Dan-BV/citroen-cold-air-intake/README.md

# Citroën Cold Air Intake Flange

A 3D-printable cold air intake duct for a Citroën engine bay. It takes air from the
radiator cross-member (a rectangular opening cut into the raised plastic bump in front of
the hood-seal lip) and delivers it through a bayonet socket to the OEM corrugated hose
(bellows) that plugs into the air-filter box.

The shape was designed in Autodesk Fusion against a photogrammetry scan of the engine bay,
scaled from the known Ø63 mm filter inlet, and checked for collisions with the scan.

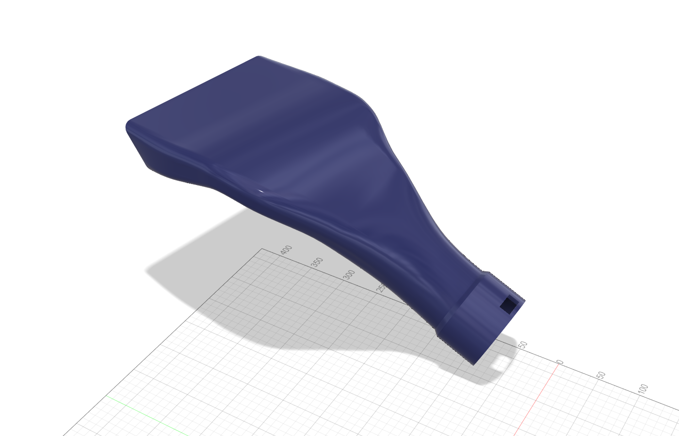
[picture p1: images/final_iso.png]
Final part


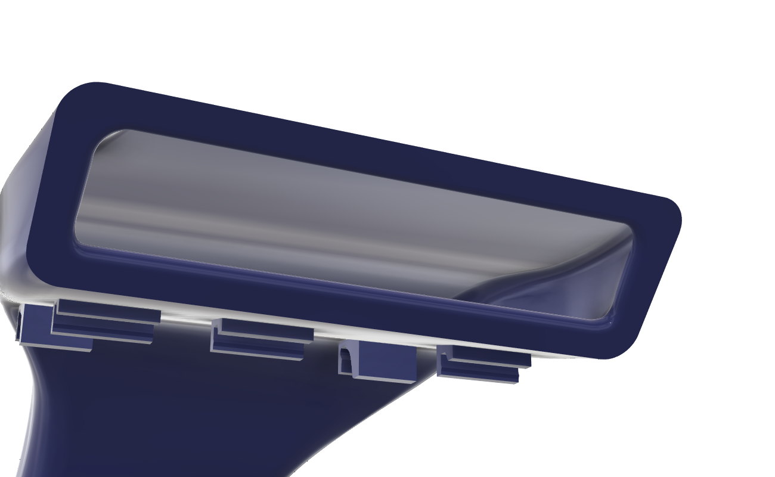
[picture p2: images/mouth_iso.png]
Mouth


## Repository layout

| Path | Contents |
|---|---|
| `model/` | Final assembled part (`.f3d`, `.step`, `.stl`) in car coordinates |
| `parts/` | The three print parts, already oriented for printing (`.stl`, `.step`, `.f3d`) |
| `print/` | Fusion print layout with all three parts on the bed |
| `references/flange_scan/` | 3D scan (OBJ) of the OEM bayonet flange used as the pattern for the outlet socket |
| `references/bellows_scan/` | 3D scan (OBJ) of the OEM corrugated hose (bellows) |
| `images/` | Renders |

All STL files are in millimetres. The full-resolution Part 1 and Part 2 STLs (≈ 105 / 55 MB,
0.01 mm chord tolerance) are too large for the repository, so they are stored zipped as
`parts/Part1_mouth_clips.stl.zip` and `parts/Part2_bend_tube.stl.zip`.

## Design summary

| Feature | Value |
|---|---|
| Inlet (mouth) | 160 × 45 mm (R9 corners) on the flat part of the rear wall of the cross-member bump, centred on it; window 140 × 25 mm (≈ 35 cm²) |
| Mounting face | Planar land offset 1 mm from the bump wall (measured profile) for 1 mm double-sided tape; land 10 mm wide all round on the flat wall |
| Inlet edge | Sharp edge; the inner walls run as straight ramps from the window to the duct over the seal lip |
| Wall thickness | 2.5 mm (wedge up to 10 mm at the mouth land) |
| Shape | Straight entry over the floor rib and the hood-seal lip (floor 16.9 mm above the floor of the apron, about 1.8 mm above the lip top), then one smooth bend down in which the section blends into a Ø63 tube, a straight Ø63 section (collar joint) and a short R55 bend onto the bellows-flange axis. Plan view: smooth trumpet 160 → ≈ 131 mm over the lip → Ø63. Narrowest section of the whole intake is the Ø54 ring of the bayonet flange (22.9 cm²); the duct over the lip is ≈ 23.5 cm² |
| Outlet | Separate bayonet flange (Part 3) on the Ø63 spigot, fitted to the measured bellows cuff with every diameter 1 mm larger than the cuff: OD 73 mm, height 46 mm; spigot sleeve Ø63.3 × 10 mm → 45° cone → Ø54 ring (flush with the cuff bore) → cuff stop → Ø62 → R4 shoulder → Ø64 up to the rim; two through windows 29° × 10 mm, two entry grooves (to Ø68) from the rim down to the windows, 30° twist; twist-lock counter-clockwise viewed into the filter inlet |
| Spigot / flange joint | The Part 2 bore narrows from Ø58 to Ø54 inside the spigot along an S-curve of two tangent R38.8 arcs (no kinks); the spigot tip is a 45° cone that seats on the flange cone, so the flow path is a continuous Ø54 from Part 2 through the flange ring into the bellows cuff, with no step or gap |
| Bellows fit | OEM bellows cuff (measured): end Ø59 with R1 edge, sealing bead Ø61, Ø60, R4 shoulder, Ø63, wall 2.5 mm (bore Ø54); two wedge lugs 15 mm wide × 9 mm long, rising to 2.5 mm (Ø67) at the back, 26 mm from the cuff end. Clearance 0.5 mm per side radially and around the lugs, 0.5 mm axial lug play. Free length ≈ 146 mm, fully compressed ≈ 109 mm; the rim position in the car is unchanged, the cuff stop is 1 mm closer to the filter than in the previous flange |
| Bellows position | Flange rim 81 mm from the filter-inlet rim (bellows close to its free length), bellows bend 25° |
| Collar joint | On the straight Ø63 section: the Part 2 collar (ID 63.3, OD 67.3, 10 mm) slides over the Part 1 tube end, butt joint with a flush Ø58 bore, 25° cone from the collar to the tube |
| Clip | Separate clip (`parts/Clip_v25`, 26 mm wide) at the mouth centre. It hooks under the rear overhang of the hood-seal lip, its top rests on the lip and its front stop runs down the lip face. It is bonded with epoxy to a tongue under the Part 1 floor through a glue tray on the clip. The tray gives ±3° / ±1 mm of play, because the lip is not parallel to the bump wall |

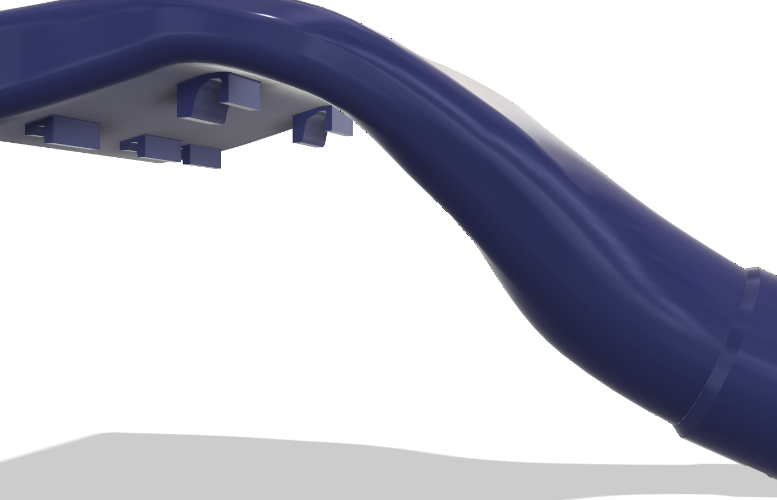
[picture p3: images/final_side.png]
Side view


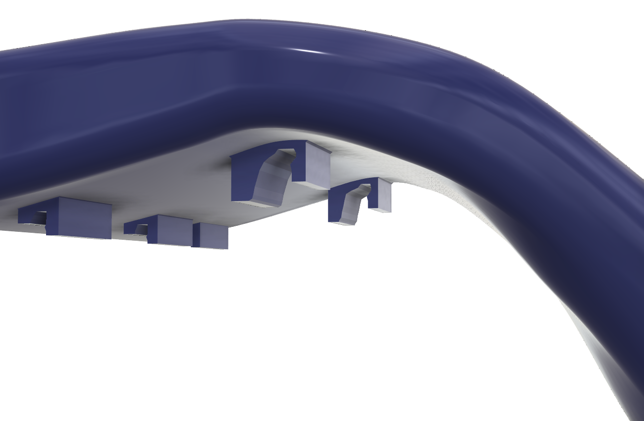
[picture p4: images/clips_side.png]
Clips


## Printing

Tested setup: Creality Ender 3 Pro (220 × 220 × 250 mm), **PETG** 1.75 mm.
PLA/PLA+ is not suitable under the hood (softens at 55–60 °C). PETG is fine at the
cross-member, especially with an external heat-reflective wrap. ASA/ABS or PA-CF are better
if you have an enclosed printer.

| Part | Size (mm) | Orientation (as exported) | Supports |
|---|---|---|---|
| `Part1_mouth_clips` | 161 × 94 × 241 | Standing on the long lower edge of the mouth, tube up (B2) | No slicer supports. Print `print/Part1_v25_B2_with_prop.stl.zip`, which includes a breakaway rib prop with a ≥ 0.32 mm gap. The prop keeps the tall part from tipping and is never inside the duct or the mouth window |
| `Clip_v25` | 21 × 6.5 × 26 | End face on the bed | None |
| `Part2_bend_tube` | 67 × 84 × 92 | Spigot tip down, collar up (use the brim of the B2 profile) | None: no overhang inside the bore is steeper than 50° (the bend leans at most 39°); outside only the 45° spigot tip chamfer and ≈ 3 cm² under the collar cone |
| `Part3_bayonet_flange` | 73 × 73 × 46 | Base (spigot sleeve) down | None (45° cone under the stop ring, windows bridge ≈ 18 mm) |

The Cura profile used for the parts is `print/cura/Ender3Pro_PETG_CAI.curaprofile` (import it via
Preferences → Profiles → Import). For Part 1 with the prop use `print/cura/Ender3Pro_PETG_CAI_v25_B2.curaprofile`:
the same settings plus a 10 mm brim, a z-hop over printed parts, and supports off. Its +0.9 mm Z offset (`adhesion_z_offset`) needs the Z Offset
Setting plugin from the Cura Marketplace; adjust it to your own printer.

Suggested PETG settings: nozzle 240–245 °C, bed 80 °C (glue stick as release layer),
fan 30–40 %, 40–50 mm/s, 4 perimeters, 30 % gyroid. Add a modifier over the clip area with
100 % infill and 5–6 perimeters. Brim 5–8 mm for parts 1 and 2. Dry the filament if it is not
fresh. Total material ≈ 400 g.

Part 1 in the B2 orientation has no overhang that needs support. The only downward face is the
underside of the tongue, ≈ 0.9 cm², which is only ≈ 1.2 mm above the duct wall below it. Use glue
stick and avoid drafts: the part is tall. After printing, snap off the prop and trim the brim flush
on the tape land. Parts 2 and 3 print with slicer supports restricted to "touching build plate"
(Z gap 0.2 mm), if any are needed.

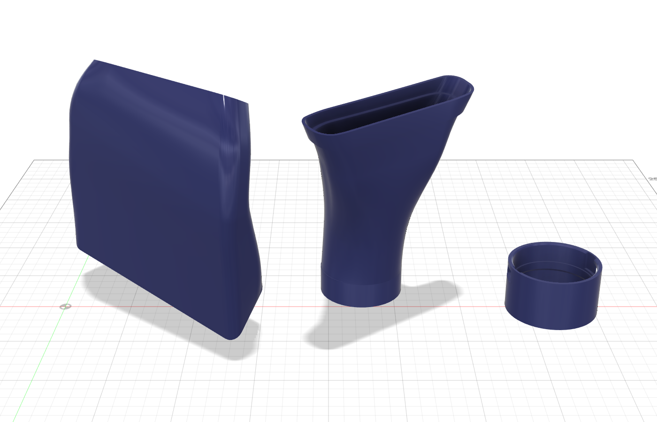
[picture p5: images/print_layout.png]
Print layout


### Fit test (optional)

The v25 test piece confirmed the fit on the car; `parts/` now holds the v25 Part 1 and clip.

v25 fixes the skew seen with the v24 test piece. The seal lip is not parallel to the bump wall:
near the clip its front face runs about 2° toward the bump and its top rises about 1°. A rigid
clip that is part of Part 1 therefore twists the whole part on the lip. In v25 the clip is a
separate piece that is bonded to Part 1 in place:
- **Clip** (`print/CAI_v25_clip.stl`, 21 × 6.5 × 26 mm): the v24 interface with the lip, plus a glue
  tray that opens upward, with end walls so that thin epoxy cannot run out. The interface: the top
  rests on the lip, the tooth sits 0.65 mm under the rear overhang, and the front stop runs down the
  lip face.
- **Part 1:** no saddle. A 19.8 × 5.3 mm tongue under the floor drops into the tray. It has about
  1 mm clearance to the tray bottom and 1–1.5 mm to the walls, so the clip can sit up to ±3° and
  about ±1 mm off the nominal position.
- **Unchanged from v24:** the land is 1.0 mm from the bump wall all round, the mouth frame has the full
  10 mm land, and the floor over the lip is at 16.9 mm.

Files:
- `print/CAI_v25_fit_test_with_clip.stl`: the test piece and the clip in one print. The test piece
  has a 5 mm deep mouth frame with the full tape land, a narrow spine from the frame to the tongue,
  and a slope where the spine meets the frame. The clip stands on its end face directly under the
  tongue, with a 0.8 mm rib support from the clip up to the tongue (≥ 0.4 mm gap) and a small bridge
  over the lip notch.
- `print/CAI_v25_fit_test_light.stl`: the test piece alone.

Print with `print/cura/Ender3Pro_PETG_TEST_fit_v25_fast.curaprofile`:
- 0.30 mm layers, 2 walls of 0.45 mm, 0 % infill;
- 80 mm/s;
- supports **off** (the rib support is part of the model);
- 7 mm brim against corner lift;
- the estimate is about 1 h 15 min to 1 h 25 min.

Glue stick on the bed and no draft help keep the frame corners down. Trim the brim flush, so that
no ridge is left on the tape land.

Install it on the car:
1. Fit the clip on the lip: hook the tooth under the rear overhang and press it down.
2. Fill the tray about half full with thick two-part epoxy.
3. Press the test piece, or the real Part 1, onto the bump wall through the 1 mm tape, so that the
   tongue sinks into the epoxy.
4. Hold it until the epoxy sets.

The land should sit about 1 mm from the wall all round.

(`print/CAI_v24_fit_test_light.stl`, `print/CAI_v22_fit_test_trim.stl` and `print/Part1_fit_test.stl`
are test pieces of earlier designs.)

## Assembly and installation

1. Slide the collar of **Part 2** over **Part 1** (0.15 mm clearance, 10 mm overlap) and bond
   with epoxy or CA glue (acetone does not work on PETG).
2. Slide **Part 3** (bayonet flange) over the Ø63 spigot of Part 2 (0.15 mm radial clearance,
   10 mm overlap) until the conical spigot tip seats on the internal cone. It rotates freely.
3. Cut a rectangular opening in the rear wall of the cross-member bump.
4. Fit the **clip** on the hood-seal lip at the mouth centre: hook the tooth under the rear overhang
   and press it down. Fill its tray about half full with thick two-part epoxy.
5. Apply 1 mm double-sided silicone (or VHB) tape to the mouth land and press Part 1 onto the bump
   wall, so that its tongue sinks into the epoxy. Hold it until the epoxy sets. After that the
   assembly can be removed and refitted: tilt the mouth up by about 25°, hook it on and swing it
   down.
6. Insert the bellows cuff into the flange with the lugs in the entry grooves, push it down to the
   stop ring and twist counter-clockwise so the lugs move into the windows. Do the same at the
   filter inlet, then rotate the flange to its final position and fix it to the spigot (glue or a
   small screw).

Check hood clearance above the seal lip on the car before final assembly.

## Notes

- The master Fusion file with the engine-bay scan is kept locally and is not published.
- v25 (current `parts/`): Part 1 refitted to a hand-measured seal-lip profile (the land is 1.0 mm
  from the wall, the floor over the lip is lower, there is no saddle on Part 1, and the clip is a
  separate glued piece; see the fit-test section). It is confirmed on the car with the v25 test piece.
  Part 2 and Part 3 are unchanged from v22, except that a hairline crack (≈ 0.005 mm, half the wall
  ring) at the spigot / bend junction of Part 2 was filled; the repaired Part 2 matches the master
  within 0.005 mm everywhere else.
- v22: Parts 1 and 2 were redesigned against a new, true-size engine-bay scan
  (the first scan turned out ≈ 7.8 % oversized; confirmed with caliper measurements). Part 3 is
  unchanged. The renders in `images/`, `model/` and the notes below describe earlier versions.
- `model/` is the earlier design reference (166 mm mouth, integrated OD 69 socket). The printable
  `parts/` supersede it:
  - Parts 1 and 2 were regenerated from the loft sections with a 160 mm mouth and monotonically
    decreasing widths, the clips were re-fitted to the new walls, and the Part 2 collar (0.15 mm
    clearance, 2 mm wall, 10 mm overlap) and Ø63 spigot were rebuilt. Checked against the
    engine-bay scan: only the intended clip snap / floor contact points (≤ 0.35 mm), Part 2 is clear.
  - Part 3: the first version was too shallow (23 mm instead of 31.5 mm to the cuff stop) and its
    bore (Ø62) was too small for the bellows cuff; rebuilt to the measured OEM flange (Ø64 bore,
    Ø69 lug recesses). Same spigot sleeve and base plane; the rim end is 13 mm closer to the filter
    (≥ 12 mm clearance to the engine-bay scan).
  - Part 3 was rebuilt again from a hand-measured bellows cuff (all diameters +1 mm, wedge lugs
    with a cylindrical outer face), the spigot sleeve shortened from 15 to 10 mm, and the Part 2
    spigot given an internal Ø58 → Ø54 S-taper and a conical tip. Re-checked in the car
    assembly: Part 2 outside is unchanged, the flange rim is at the same position, no interference
    between parts or with the bellows, ≥ 12 mm to the engine-bay scan.
- Dimensions of the OEM flange and bellows come from the scans in `references/` and hand
  measurements; verify fit with a test print of a clip section before printing the full part.
