Dan-BV/citroen-cold-air-intake/images/clips_bottom.png

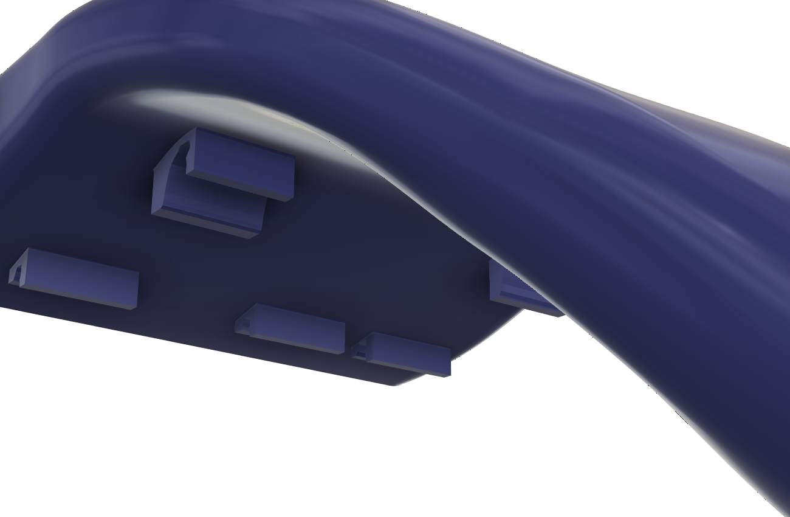
images/clips_bottom.png
