Dan-BV/citroen-cold-air-intake/images/final_front.png

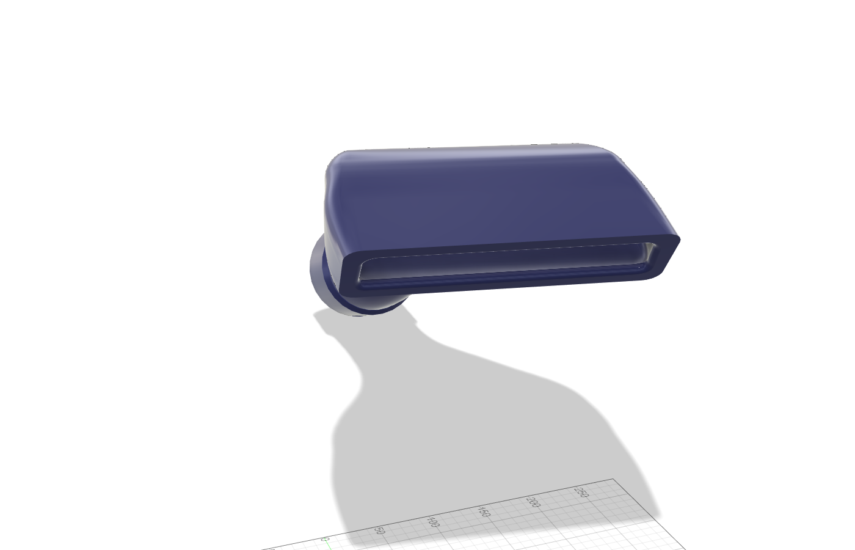
images/final_front.png
