Dan-BV/citroen-cold-air-intake/images/mouth_front.png

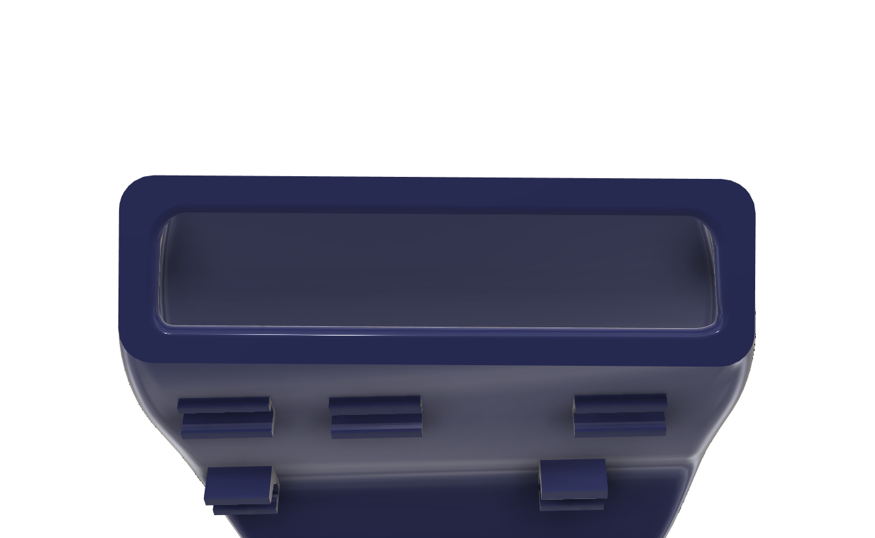
images/mouth_front.png
