Dan-BV/citroen-cold-air-intake/references/bellows_scan/tex_u1_v1_diffuse.jpg

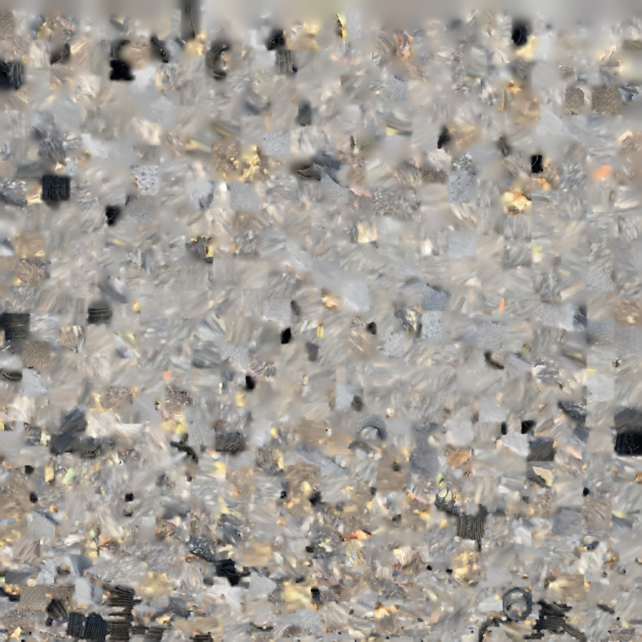
references/bellows_scan/tex_u1_v1_diffuse.jpg
