Dan-BV/citroen-cold-air-intake/references/flange_scan/tex_u1_v1_normal.jpg

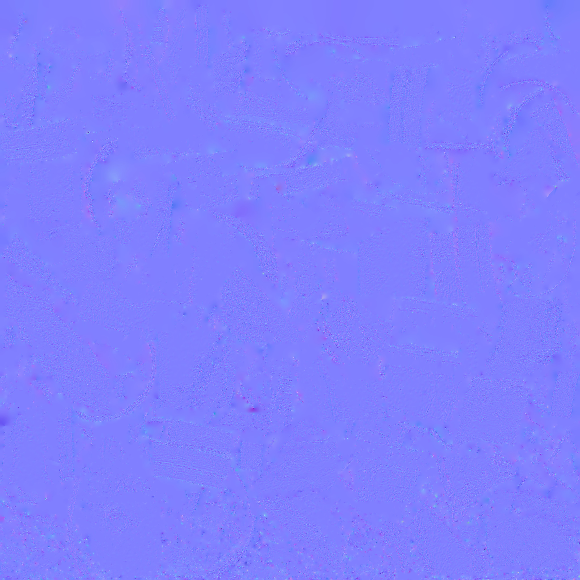
references/flange_scan/tex_u1_v1_normal.jpg
