Dan-BV/citroen-cold-air-intake/model/Citroen_CAI_Flange.step

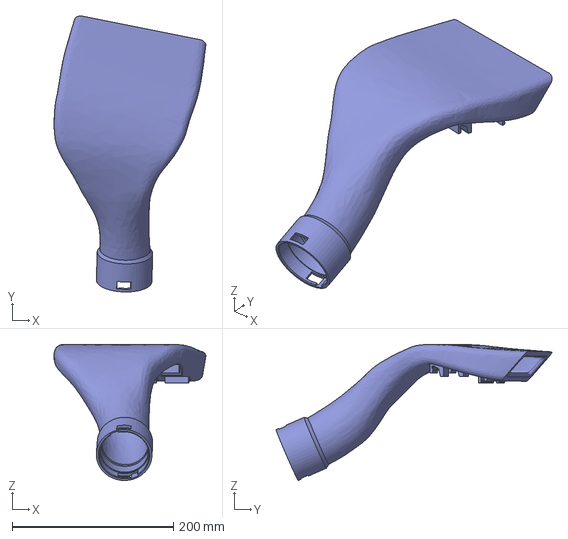
[picture p13: CAD file, 2026-09-26]
model/Citroen_CAI_Flange.step
188.2 x 342.4 x 168.7 mm
