Dan-BV/citroen-cold-air-intake/parts/Part2_bend_tube.step

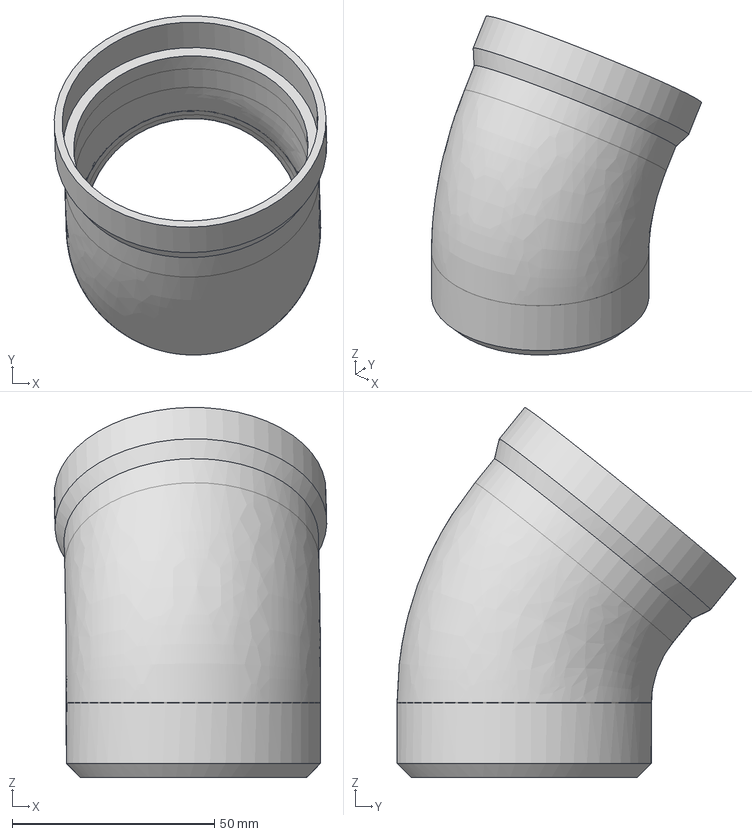
[picture p14: CAD file, 2026-10-04]
parts/Part2_bend_tube.step
67.5 x 83.9 x 91.6 mm
