Dan-BV/citroen-cold-air-intake/print/Part1_v25_B2_prop.stl

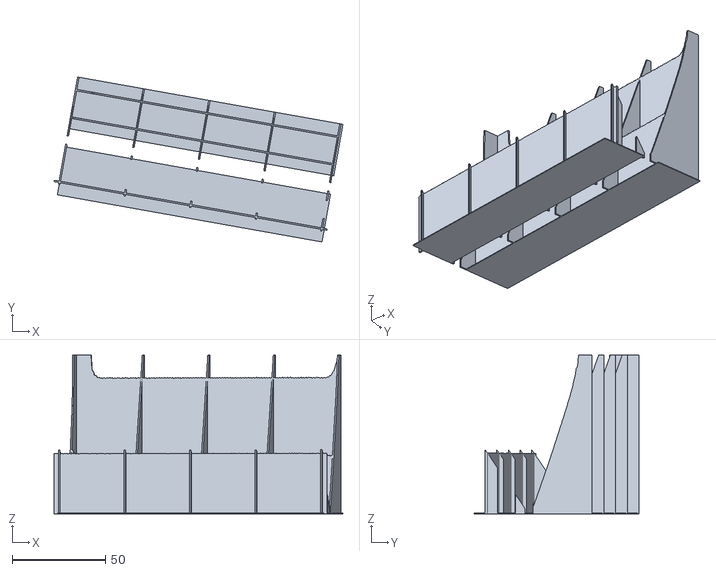
[picture p15: CAD file, 2026-10-02]
print/Part1_v25_B2_prop.stl
154.8 x 88.4 x 85.0
