Dan-BV/citroen-cold-air-intake/references/bellows_scan/Gift.obj

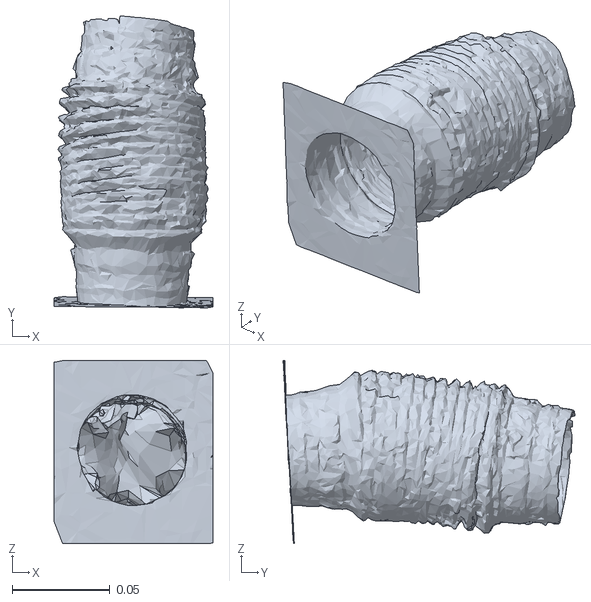
[picture p16: CAD file, 2026-09-26]
references/bellows_scan/Gift.obj
0.0814 x 0.15 x 0.0939
