Dan-BV/citroen-cold-air-intake/references/flange_scan/Flan.obj

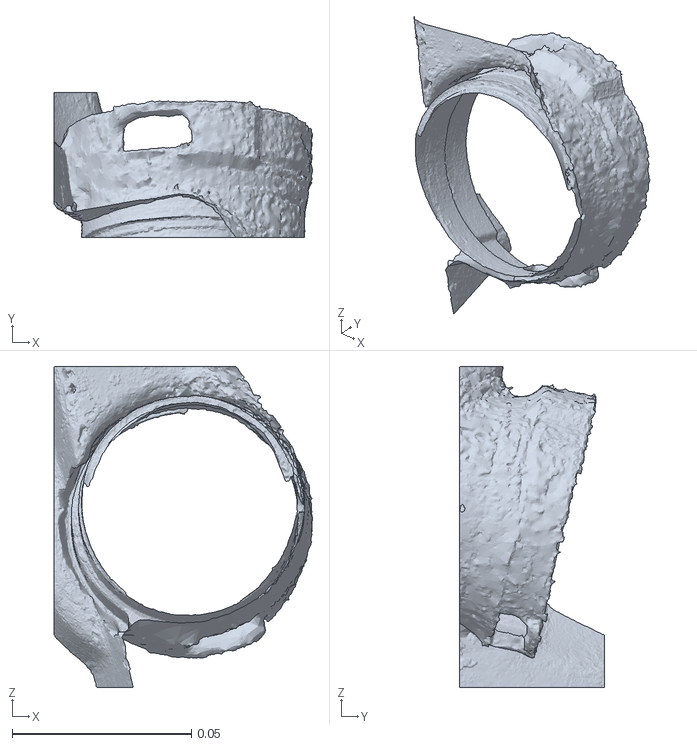
[picture p17: CAD file, 2026-09-26]
references/flange_scan/Flan.obj
0.0721 x 0.0406 x 0.0895
