Dan-BV/citroen-cold-air-intake/parts/Clip_v25.step

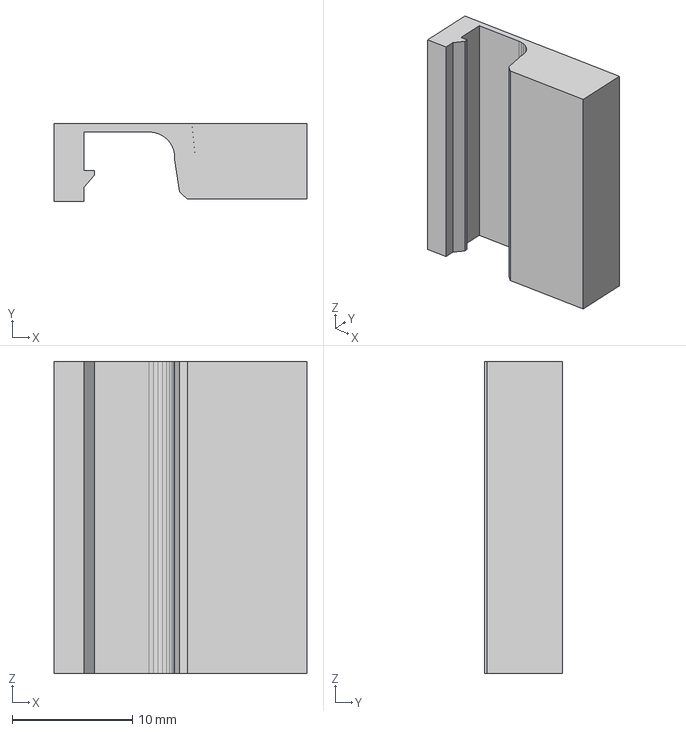
[picture p18: CAD file, 2026-10-02]
parts/Clip_v25.step
21.1 x 6.51 x 26.0 mm
