Dan-BV/citroen-cold-air-intake/parts/Part1_mouth_clips.step

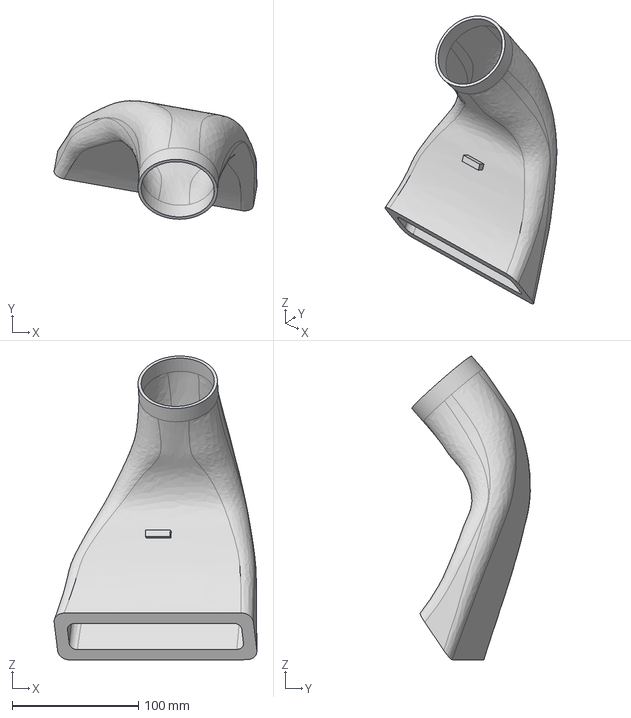
[picture p19: CAD file, 2026-10-02]
parts/Part1_mouth_clips.step
160.5 x 93.9 x 240.6 mm
