Dan-BV/citroen-cold-air-intake/print/CAI_v25_fit_test_with_clip.stl

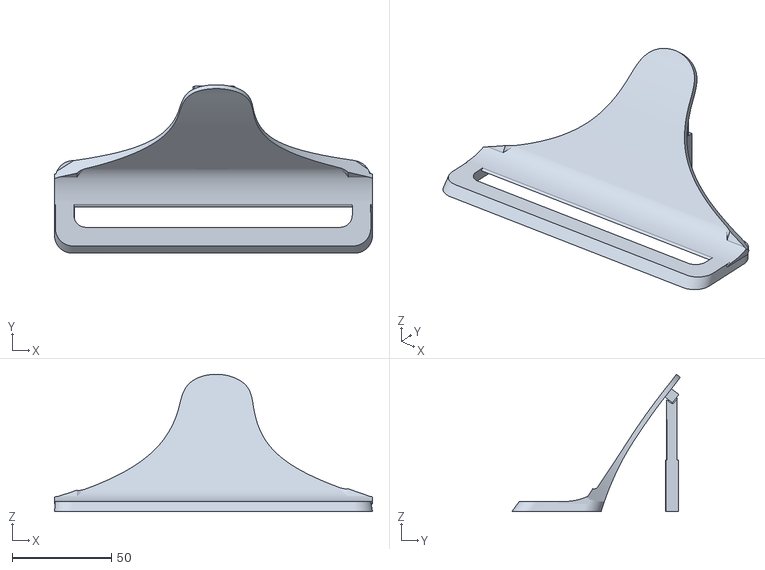
[picture p20: CAD file, 2026-10-02]
print/CAI_v25_fit_test_with_clip.stl
160.2 x 84.8 x 69.2
