Dan-BV/citroen-cold-air-intake/parts/Part3_bayonet_flange.step

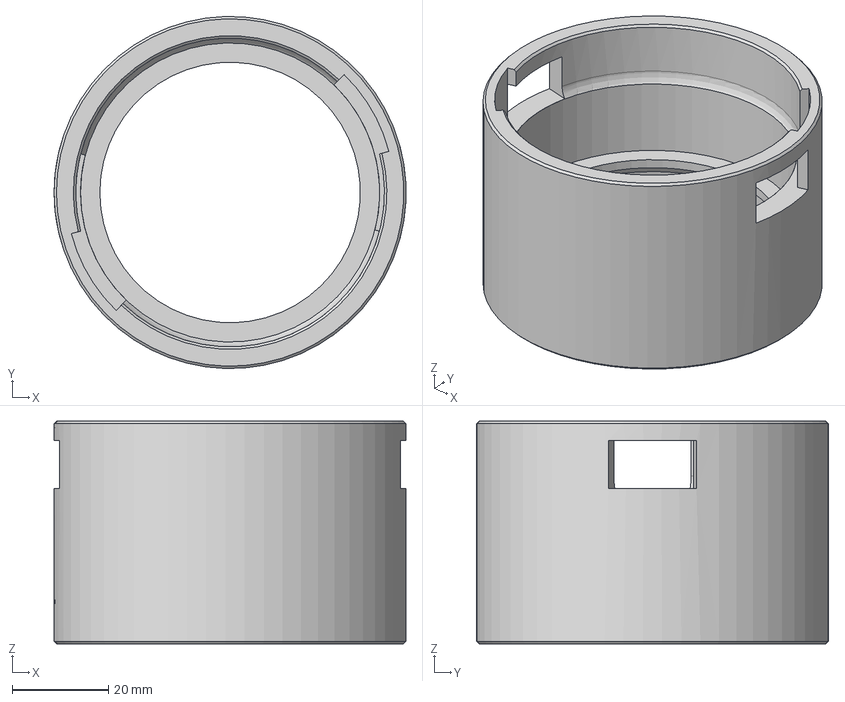
[picture p21: CAD file, 2026-09-29]
parts/Part3_bayonet_flange.step
73.0 x 73.0 x 46.1 mm
