Dan-BV/citroen-cold-air-intake/print/CAI_v25_fit_test_light.stl

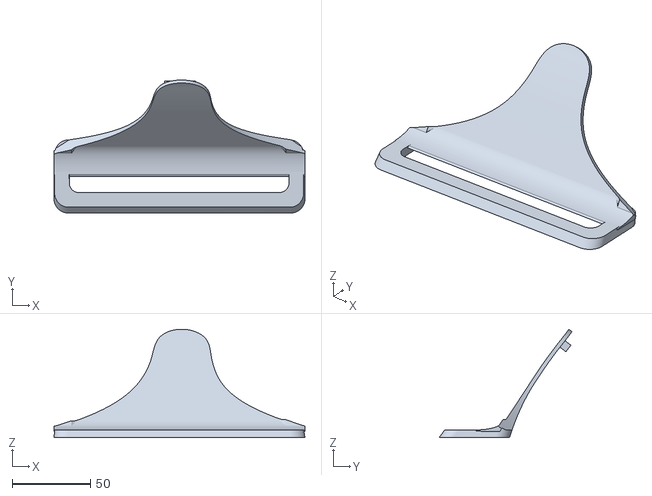
[picture p22: CAD file, 2026-10-02]
print/CAI_v25_fit_test_light.stl
160.2 x 84.8 x 69.2
