Dan-BV/citroen-cold-air-intake/print/CAI_v22_fit_test_trim.stl

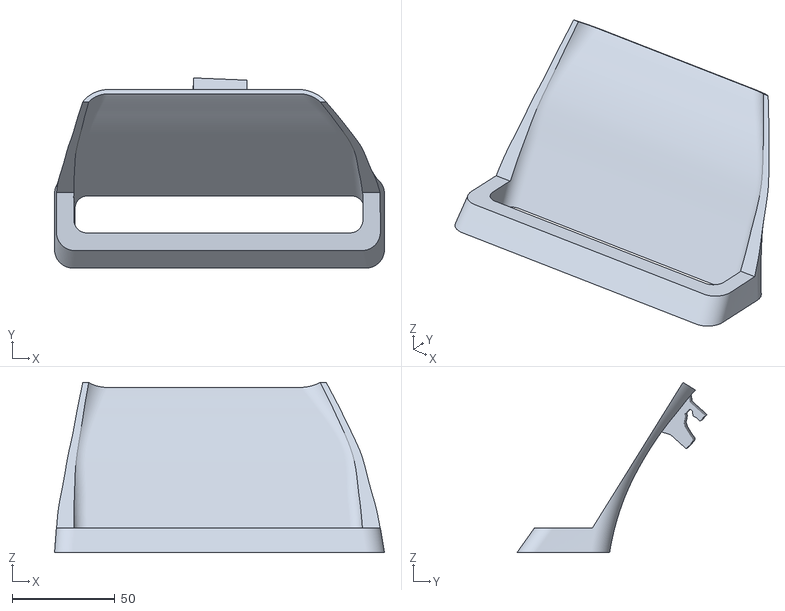
[picture p23: CAD file, 2026-10-01]
print/CAI_v22_fit_test_trim.stl
160.2 x 92.3 x 82.7
