Dan-BV/citroen-cold-air-intake/print/Part1_fit_test.stl

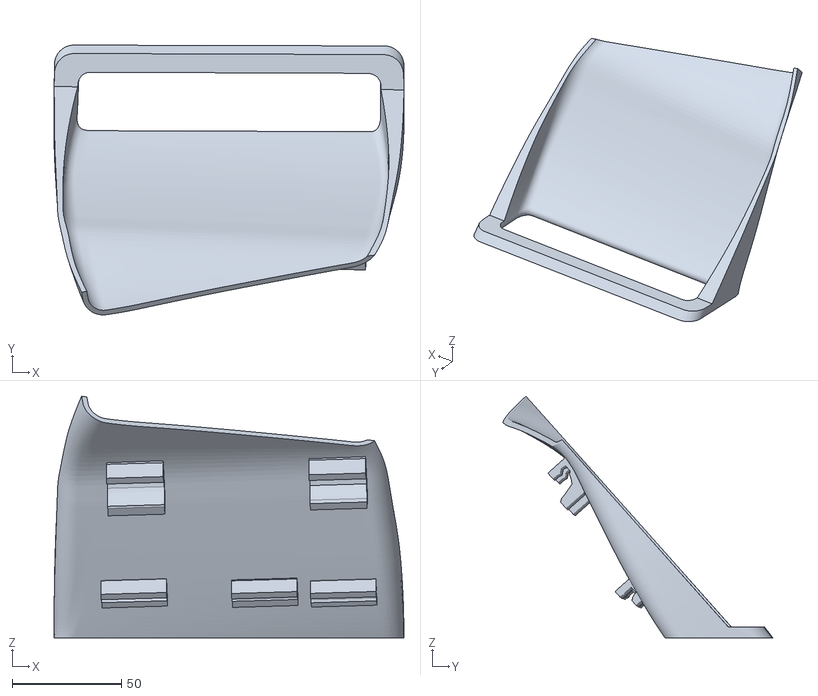
[picture p24: CAD file, 2026-09-29]
print/Part1_fit_test.stl
160.2 x 123.5 x 110.6
