Dan-BV/citroen-cold-air-intake/print/CAI_v24_fit_test_light.stl

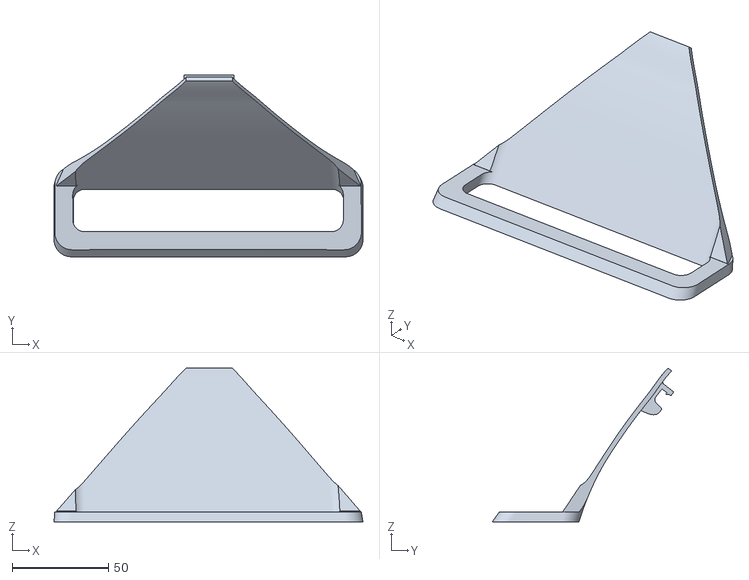
[picture p25: CAD file, 2026-10-01, an earlier design]
print/CAI_v24_fit_test_light.stl
160.2 x 94.2 x 79.7
