Dan-BV/citroen-cold-air-intake/(list of files, cad)

Other CAD files:
print/CAI_v25_clip.stl
model/Citroen_CAI_Flange.f3d
model/Citroen_CAI_Flange.stl
parts/Clip_v25.f3d
parts/Clip_v25.stl
parts/Part1_mouth_clips.f3d
parts/Part2_bend_tube.f3d
parts/Part3_bayonet_flange.f3d
parts/Part3_bayonet_flange.stl
print/Citroen_CAI_Flange_print_layout.f3d
