Dan-BV/citroen-cold-air-intake/(commit log)

2026-09-26 Add Citroen cold air intake flange: final model, print parts, reference scans
    Final v17 design: rectangular 166x49 mm mouth with 3 mm fillet and 1 mm tape
    offset, S-bend duct to a 25-deg tilted bayonet socket for the OEM bellows,
    reinforced snap clips. Includes print-oriented parts (STL/STEP/F3D), print
    layout, OEM flange and bellows OBJ scans, renders and README.
    [Citroen_CAI_Flange.f3d, Citroen_CAI_Flange.step, Citroen_CAI_Flange.stl, Citroen_CAI_Flange_print_layout.f3d, Flan.obj, Gift.obj, Part1_mouth_clips.f3d, Part1_mouth_clips.step]
2026-09-28 Rework Part3 bayonet flange to fit the OEM bellows
    The first Part3 was too shallow (23 mm to the cuff stop instead of
    31.5 mm), its entry grooves were narrower than the 15 mm lugs and the
    windows had no axial clearance for the 10.3 mm lugs.
    New flange: OD 71, height 51, stop ring 56 mm at 31.5 mm below the rim,
    32 x 11.5 mm windows, 32 deg entry grooves. Same spigot sleeve and base
    plane as before. Adds a 20 mm lock test ring and updates the README.
    [Part3_bayonet_flange.f3d, Part3_bayonet_flange.step, Part3_bayonet_flange.stl, Part3_lock_test.stl]
2026-09-28 Rebuild duct with 160 mm mouth and refit bayonet flange to OEM filter inlet
    - Parts 1 and 2 regenerated from the loft sections: 160 mm mouth (was 166),
    width now decreases monotonically from the mouth to the round tube, clips
    re-fitted to the narrower walls, Part 2 collar and Ø63 spigot rebuilt.
    - Part 3 rebuilt to the measured OEM flange: Ø64 bore, Ø69 lug recesses,
    OD 73 mm; cuff stop 31.5 mm below the rim.
    - Remove the outdated Part 3 lock test ring; update README.
    Checked against the engine-bay scan: only the intended clip/floor contacts.
    [Part1_mouth_clips.f3d, Part1_mouth_clips.step, Part1_mouth_clips.stl, Part2_bend_tube.f3d, Part2_bend_tube.step, Part2_bend_tube.stl, Part3_bayonet_flange.f3d, Part3_bayonet_flange.step]
2026-09-29 Refit Part3 flange to measured bellows cuff and taper Part2 bore to 54 mm
    - Part3: bore follows the hand-measured cuff with +1 mm on every diameter
    (Ø62 up to the R4 shoulder, Ø64 above), Ø54 stop ring flush with the cuff
    bore, windows 29° x 10 mm, entry grooves to Ø68, spigot sleeve shortened
    to 10 mm, height 46 mm.
    - Part2: spigot bore narrows Ø58 -> Ø54 along a tangent S-curve and the tip
    is a 45° cone seating on the flange cone, giving a continuous Ø54 path.
    - Re-checked in the car assembly against the engine-bay scan.
    - Full-resolution Part2 STL is shipped zipped; the raw STL stays local.
    [Part2_bend_tube.f3d, Part2_bend_tube.step, Part2_bend_tube.stl, Part3_bayonet_flange.f3d, Part3_bayonet_flange.step, Part3_bayonet_flange.stl]
2026-09-29 Reorient Part1 joint-end down and add collar chamfer to Part2
    - Part1: print orientation changed to the joint end flat on the bed
    (172 x 106 x 162 mm); all clip overhangs are reachable by plate-only
    tree supports and the tape land prints on top.
    - Part2: 25 deg chamfer (about 4.6 mm) under the outside collar step, so
    the part prints spigot-down without supports (steepest overhang 43 deg).
    - Full-resolution Part1 and Part2 STLs are shipped zipped; raw STLs stay
    local.
    - README: new orientations, sizes, collar joint description and the
    46 deg support overhang angle for Part1.
    [Part1_mouth_clips.f3d, Part1_mouth_clips.step, Part1_mouth_clips.stl, Part2_bend_tube.f3d, Part2_bend_tube.step]
2026-09-29 Add Part1 fit-test piece and hollow test Cura profile
    - print/Part1_fit_test.stl: lower half of Part1 from the seal-lip saddles
    to the mouth with all clips and the full mouth land frame, oriented
    tape-land down, to check clip-to-mouth-plane fit on the car.
    - print/cura/Ender3Pro_PETG_TEST_hollow_fit.curaprofile: fast hollow
    profile for the test piece (0.28 mm, 2 walls, 0% infill, tree supports).
    - README: short fit-test section.
    [Part1_fit_test.stl]
2026-09-29 Add main Cura profile for Ender 3 Pro PETG
    print/cura/Ender3Pro_PETG_CAI.curaprofile: the working profile used for the
    duct parts (0.2 mm layers, 4 walls, 40% gyroid, 235/240 C nozzle, 80 C bed,
    bridges enabled, Z offset +0.9 mm via ZOffsetPlugin).
2026-10-01 Redesign Part1 and Part2 (v22) against the true-size engine-bay scan
    - Mouth 160 x 45 mm with a 10 mm planar tape land fully on the flat bump wall
    (+1 mm tape gap), window 140 x 25 mm, straight inner ramps.
    - Straight entry over the floor rib and seal lip, one smooth bend blending into
    a Ø63 tube, straight collar section and a short R55 bend onto the bellows axis.
    - Bayonet flange (Part3, unchanged) moved so the bellows is near free length:
    81 mm rim to filter inlet, 25 deg bend.
    - One central snap saddle on the seal lip (hook 1 mm tighter), floor-rib clips removed.
    - New fit-test piece (mouth land frame + floor + saddle) and its Cura profile.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
    [CAI_v22_fit_test_trim.stl, Part1_mouth_clips.f3d, Part1_mouth_clips.step, Part2_bend_tube.f3d, Part2_bend_tube.step]
2026-10-01 Add v24 fit-test piece fitted to the measured seal-lip profile
    The v22 test piece did not snap onto the seal lip and the tape land stood
    about 5 mm off the bump wall: the clip had been fitted to the scan, which
    shows the lip bead about 3 mm too high. v24 refits Part 1 to the
    hand-measured lip profile (land 1.0 mm from the wall, lower tunnel floor,
    hook-and-swing clip). The test piece is a light cut of it: a 5 mm mouth
    frame, a wedge-shaped floor and the clip.
    [CAI_v24_fit_test_light.stl]
2026-10-02 Add v25 fit-test piece with a separate glued clip
    On the car the v24 test piece seated on the lip, but the tape land stood skewed to the bump wall:
    the seal lip is not parallel to the bump, and the rigid one-piece clip twisted the part. v25 makes
    the clip a separate piece with an upward glue tray. Part 1 gets a tongue that drops into the tray,
    so the clip can follow the lip while the land stays flat on the bump wall.
    The test piece is cut to a light spine with a frame slope. It is printed together with the clip,
    which carries a rib support under the tongue. Add a faster Cura profile for it (0.3 mm layers,
    2 walls, no slicer supports, brim).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
    [CAI_v25_clip.stl, CAI_v25_fit_test_light.stl, CAI_v25_fit_test_with_clip.stl]
2026-10-02 Release v25 Part 1 with a separate glued clip, printed on the mouth edge
    The v25 test piece fitted on the car, so the v25 parts replace v22 in parts/:
    - Part 1 is refitted to the hand-measured seal-lip profile: the land is 1.0 mm from the
    bump wall and the floor over the lip is lowered. It has no saddle, only a tongue under
    the floor.
    - Clip_v25 is a separate clip that hooks under the lip overhang and carries an upward glue
    tray. It is bonded to the tongue in place, which absorbs the angle between the lip and
    the bump wall.
    Part 1 is exported standing on the long lower edge of the mouth (B2), with no overhangs that
    need supports. A breakaway rib prop (>= 0.32 mm gap, never inside th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
    [Clip_v25.f3d, Clip_v25.step, Clip_v25.stl, Part1_mouth_clips.f3d, Part1_mouth_clips.step, Part1_v25_B2_prop.stl]
2026-10-04 Fill the hairline crack in Part 2 at the spigot / bend junction
    [Part2_bend_tube.f3d, Part2_bend_tube.step]
